skilaru1/ece3872swProj/HWProj/design.brd

## EAGLE design HWProj/design.brd (2020-04-04)

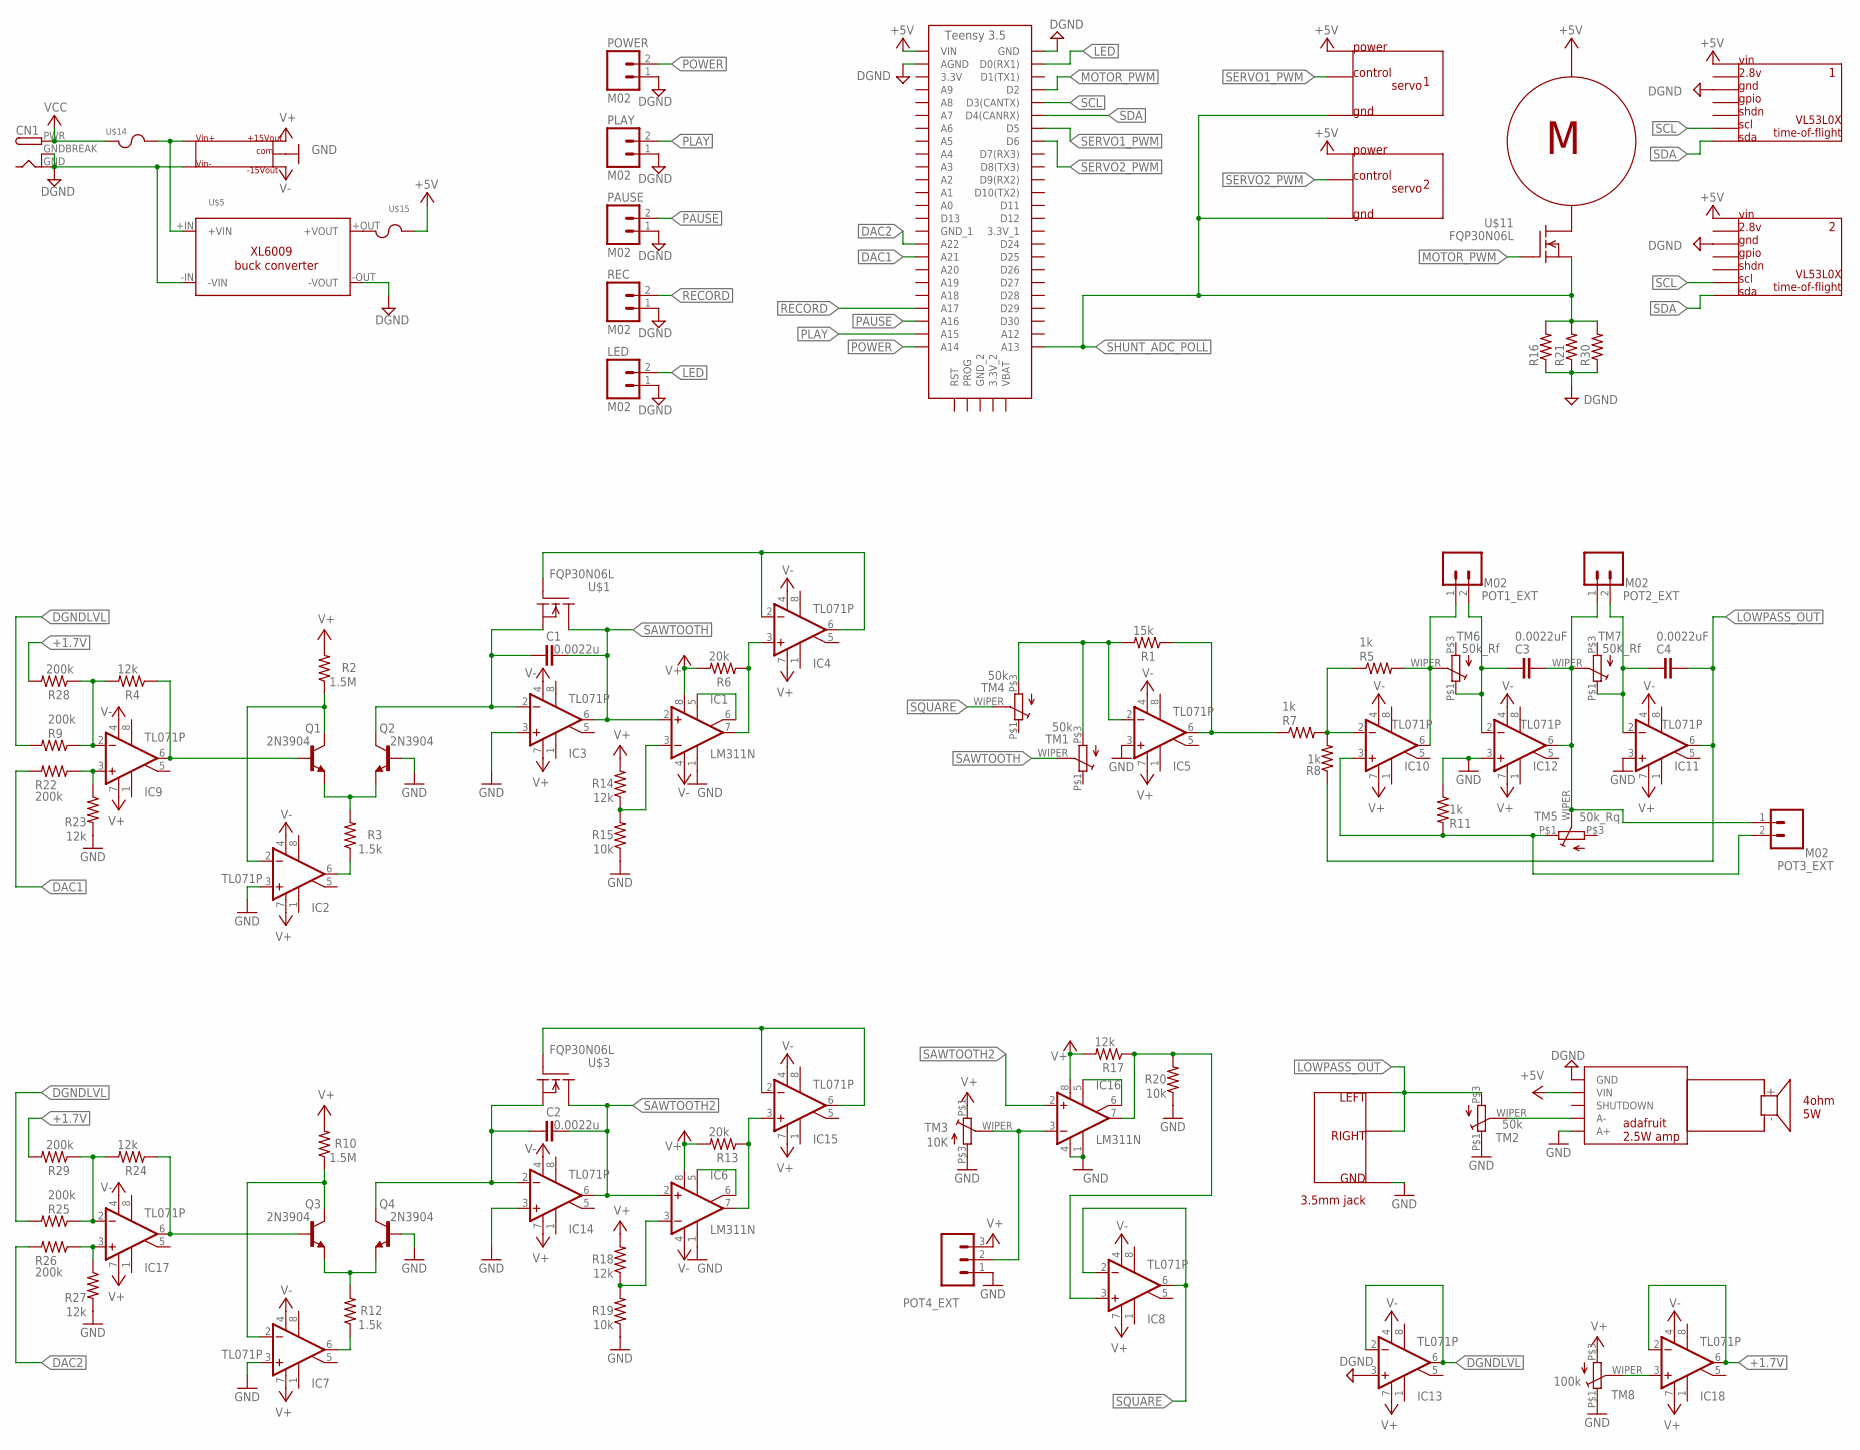
[picture p1: schematic design.sch]

Parts:
C1, C2: 0.0022u; CAP-PTH-5MM
C3, C4: 0.0022uF; CAP-PTH-5MM
CN1: DCBARRELPTH; DCJACK_2MM_PTH
IC1, IC6, IC16: LM311N; DIL08
IC2, IC3, IC4, IC5, IC7, IC8, IC9, IC10, IC11, IC12, IC13, IC14, IC15, IC17, IC18: TL071P; DIL08
LED: M02; 1X02
PAUSE: M02; 1X02
PLAY: M02; 1X02
POT1_EXT, POT2_EXT, POT3_EXT: M02; 1X02
POT4_EXT: M03; 1X03
POWER: M02; 1X02
Q1, Q2, Q3, Q4: 2N3904; TO92
R1: 15k; AXIAL-0.3
R2, R10: 1.5M; AXIAL-0.3
R3, R12: 1.5k; AXIAL-0.3
R4, R14, R17, R18, R23, R24, R27: 12k; AXIAL-0.3
R5, R7, R8, R11: 1k; AXIAL-0.3
R6, R13: 20k; AXIAL-0.3
R9, R22, R25, R26, R28, R29: 200k; AXIAL-0.3
R15, R19, R20: 10k; AXIAL-0.3
R16, R21, R30: RESISTORAXIAL-0.3; AXIAL-0.3
REC: M02; 1X02
TM1, TM2, TM4: 50k; 3386_TRI
TM3: 10K; 3386_TRI
TM5: 50k_Rq; 3386_TRI
TM6: 50k_Rf; 3386_TRI
TM7: 50K_Rf; 3386_TRI
TM8: 100k; 3386_TRI
U$1, U$3, U$11: FQP30N06L; TO-220
U$2: PAM8302A_ADAFRUIT
U$4: TEENSY_3.5_EXT
U$5: DC/DC-STEP-DOWN-XL6009; DC/DC-STEP-UP-XL6009
U$6: 3.5MM_AUDIO_JACK
U$7: +/-15V_BOOST_CONVERTER
U$8, U$9: SERVO_3PIN_HEADER
U$10: 3872_MOTOR
U$12, U$13: VL53L0X
U$14, U$15: FUSE_5X20MM; 0751.0110

Connections:
+1.7V: IC18.2 (-IN), IC18.6 (OUT), R28.P$2 (2), R29.P$2 (2)
+5V: U$2.VIN, U$4.VIN, U$8.POWER, U$9.POWER, U$10.+, U$12.VIN, U$13.VIN, U$15.R1 (2), U$15.R2 (2)
BANDPASS_OUT: C3.1, IC12.6 (OUT), POT2_EXT.1, POT3_EXT.1, TM5.WIPER (S), TM7.WIPER (S)
COMP_SQ_OUT: IC8.3 (+IN), IC16.7 (OUT), R17.P$1 (1), R20.P$2 (2)
DAC1: R22.P$2 (2), U$4.A21
DAC2: R26.P$2 (2), U$4.A22
DGND: CN1.GND, CN1.GNDBREAK, IC13.3 (+IN), LED.1, PAUSE.1, PLAY.1, POWER.1, R16.P$1 (1), R21.P$1 (1), R30.P$1 (1), REC.1, U$2.GND, U$4.AGND, U$4.GND, U$5.-IN (-VIN), U$5.-OUT (-VOUT), U$7.1, U$12.GND, U$13.GND
DGNDLVL: IC13.2 (-IN), IC13.6 (OUT), R9.P$2 (2), R25.P$2 (2)
GND: IC1.1 (GND), IC2.3 (+IN), IC3.3 (+IN), IC5.3 (+IN), IC6.1 (GND), IC7.3 (+IN), IC11.3 (+IN), IC12.3 (+IN), IC14.3 (+IN), IC16.1 (GND), IC16.4 (V-), POT4_EXT.1, Q2.2 (B), Q4.2 (B), R11.P$1 (1), R15.P$1 (1), R19.P$1 (1), R20.P$1 (1), R23.P$2 (2), R27.P$2 (2), TM2.P$1 (E), TM3.P$3 (A), TM8.P$1 (E), U$2.A+, U$6.GND, U$7.7
HIGHPASS_OUT: IC10.6 (OUT), POT1_EXT.1, R5.P$2 (2), TM6.WIPER (S)
INPUT2: IC5.6 (OUT), R1.P$1 (1), R7.P$1 (1)
LED: LED.2, U$4.D0(RX1)
LOWPASS_OUT: C4.1, IC11.6 (OUT), R8.P$1 (1), TM2.P$3 (A), U$6.L, U$6.R
MOTOR_PWM: U$4.D2, U$11.1 (G)
unnamed: TM2.WIPER (S), U$2.A-
unnamed: Q1.3 (E), Q2.3 (E), R3.P$2 (2)
unnamed: Q3.3 (E), Q4.3 (E), R12.P$2 (2)
unnamed: IC18.3 (+IN), TM8.WIPER (S)
unnamed: IC2.6 (OUT), R3.P$1 (1)
unnamed: IC1.7 (OUT), IC4.3 (+IN), R6.P$1 (1)
unnamed: C1.1, IC3.2 (-IN), Q2.1 (C), U$1.3 (S)
unnamed: IC6.7 (OUT), IC15.3 (+IN), R13.P$1 (1)
unnamed: IC1.5 (ON), IC1.6 (ON/STR)
unnamed: IC4.2 (-IN), IC4.6 (OUT), U$1.1 (G)
unnamed: IC17.3 (+IN), R26.P$1 (1), R27.P$1 (1)
unnamed: IC2.2 (-IN), Q1.1 (C), R2.P$1 (1)
unnamed: IC7.6 (OUT), R12.P$1 (1)
unnamed: C2.1, IC14.2 (-IN), Q4.1 (C), U$3.3 (S)
unnamed: IC6.5 (ON), IC6.6 (ON/STR)
unnamed: IC15.2 (-IN), IC15.6 (OUT), U$3.1 (G)
unnamed: IC16.5 (ON), IC16.6 (ON/STR)
unnamed: IC10.2 (-IN), R5.P$1 (1), R7.P$2 (2), R8.P$2 (2)
unnamed: IC17.6 (OUT), Q3.2 (B), R24.P$1 (1)
unnamed: C3.2, IC12.2 (-IN), POT1_EXT.2, TM6.P$1 (E)
unnamed: IC7.2 (-IN), Q3.1 (C), R10.P$1 (1)
unnamed: C4.2, IC11.2 (-IN), POT2_EXT.2, TM7.P$1 (E)
unnamed: IC6.3 (-IN), R18.P$1 (1), R19.P$2 (2)
unnamed: IC1.3 (-IN), R14.P$1 (1), R15.P$2 (2)
unnamed: IC10.3 (+IN), POT3_EXT.2, R11.P$2 (2), TM5.P$1 (E)
unnamed: IC16.3 (-IN), POT4_EXT.2, TM3.WIPER (S)
unnamed: IC17.2 (-IN), R24.P$2 (2), R25.P$1 (1), R29.P$1 (1)
unnamed: IC5.2 (-IN), R1.P$2 (2), TM1.P$3 (A), TM4.P$3 (A)
unnamed: U$5.+IN (+VIN), U$7.2, U$14.R1 (2), U$14.R2 (2)
unnamed: IC9.2 (-IN), R4.P$2 (2), R9.P$1 (1), R28.P$1 (1)
unnamed: IC9.3 (+IN), R22.P$1 (1), R23.P$1 (1)
unnamed: U$5.+OUT (+VOUT), U$15.L1 (1), U$15.L2 (1)
unnamed: U$10.-, U$11.2 (D)
PAUSE: PAUSE.2, U$4.A16
PLAY: PLAY.2, U$4.A15
POWER: POWER.2, U$4.A14
RECORD: REC.2, U$4.A17
SAWTOOTH: C1.2, IC1.2 (+IN), IC3.6 (OUT), TM1.WIPER (S), U$1.2 (D)
SAWTOOTH2: C2.2, IC6.2 (+IN), IC14.6 (OUT), IC16.2 (+IN), U$3.2 (D)
SCL: U$4.D3(CANTX), U$12.SCL, U$13.SCL
SDA: U$4.D4(CANRX), U$12.SDA, U$13.SDA
SERVO1_PWM: U$4.D5, U$8.CONTROL
SERVO2_PWM: U$4.D6, U$9.CONTROL
SHUNT_ADC_POLL: R16.P$2 (2), R21.P$2 (2), R30.P$2 (2), U$4.A13, U$8.GND, U$9.GND, U$11.3 (S)
SIGNAL1: IC9.6 (OUT), Q1.2 (B), R4.P$1 (1)
SQUARE: IC8.2 (-IN), IC8.6 (OUT), TM4.WIPER (S)
V+: IC1.8 (V+), IC2.7 (V+), IC3.7 (V+), IC4.7 (V+), IC5.7 (V+), IC6.8 (V+), IC7.7 (V+), IC8.7 (V+), IC9.7 (V+), IC10.7 (V+), IC11.7 (V+), IC12.7 (V+), IC13.7 (V+), IC14.7 (V+), IC15.7 (V+), IC16.8 (V+), IC17.7 (V+), IC18.7 (V+), POT4_EXT.3, R2.P$2 (2), R6.P$2 (2), R10.P$2 (2), R13.P$2 (2), R14.P$2 (2), R17.P$2 (2), R18.P$2 (2), TM3.P$1 (E), TM8.P$3 (A), U$7.6
V-: IC1.4 (V-), IC2.4 (V-), IC3.4 (V-), IC4.4 (V-), IC5.4 (V-), IC6.4 (V-), IC7.4 (V-), IC8.4 (V-), IC9.4 (V-), IC10.4 (V-), IC11.4 (V-), IC12.4 (V-), IC13.4 (V-), IC14.4 (V-), IC15.4 (V-), IC17.4 (V-), IC18.4 (V-), U$7.8
VCC: CN1.PWR, U$14.L1 (1), U$14.L2 (1)

Notes on the sheet:
4ohm 5W
3.5mm jack

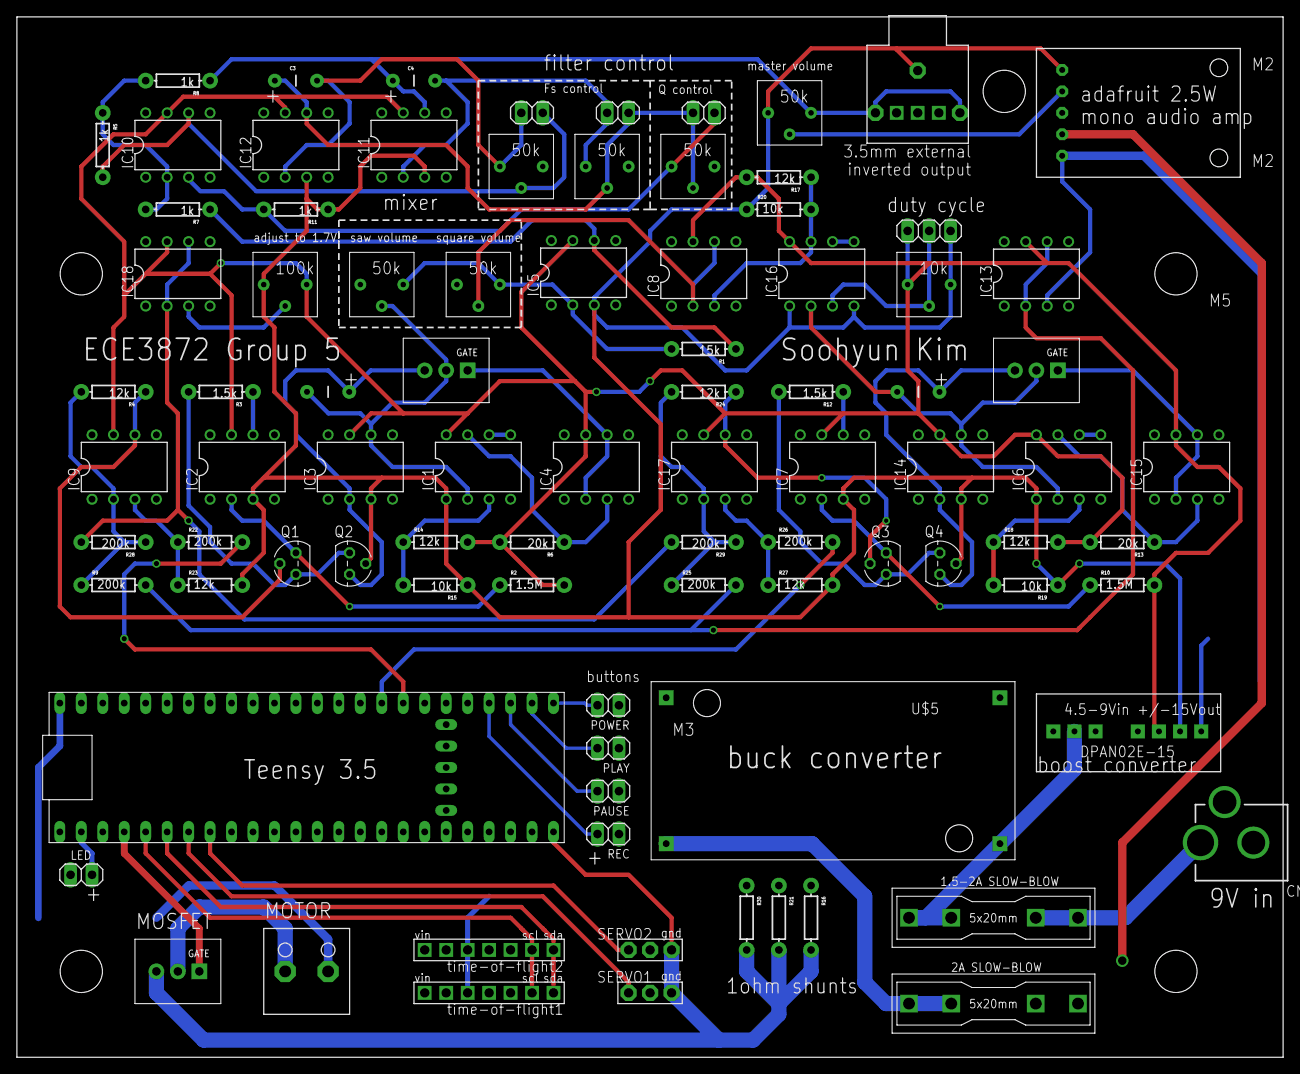
[picture p2: board design.brd from above]

Board: 2 copper layers, 149.8 x 123.1 mm, 89 parts (0 on the bottom side), 63 nets.
