skilaru1/ece3872swProj/(commit log)

2020-02-04 Left turn not working
    [SWProj.ino]
2020-02-05 fixed curr zero issue
    [SWProj.ino]
2020-02-25 added schematic
    [design.sch]
2020-02-26 1st order vcf and 2nd order manual filter added (unsimulated)
    [design.sch]
2020-02-27 tested two-pole filter circuit, determined r/c val
    [design.sch]
2020-02-27 removed extraneous components for analog--complete
    [design.sch]
2020-02-28 incorporated adafruit amp, minor revisions
    [design.sch]
2020-03-04 begin designing entire schematic, added power
    [design.sch]
2020-03-04 changed value of volume control pot at speaker stage to 50k
    [design.sch]
2020-03-04 corrected teensy vin
    [design.sch]
2020-03-06 added teensy 3.5 DAC test code
2020-03-07 completed initial design for testing, revisions
    [design.sch]
2020-03-09 added 3.5mm jack
    [design.sch]
2020-03-09 fixed ground ref for amp, replaced boost converter
    [design.sch]
2020-03-10 added board rev0
    [design.brd, design.sch]
2020-03-10 revised board rev0.2
    [design.brd]
2020-03-11 added motor, sensors, and servos--board rev1
    [design.brd, design.sch]
2020-03-11 silkscreen cleanup, tested square generation
    [design.brd, design.sch]
2020-03-12 added fuses, shunt system, finalized board rev1.1
    [design.brd, design.sch]
2020-03-12 revised teensy test code to light LED
2020-04-02 Added code for button and servo functions
2020-04-03 attempted integration of buttons and servos
    [design.brd, design.sch]
2020-04-03 minor commit; added silkscreen text
    [design.brd]
2020-04-04 post-prototype evaluation revisions
    [design.brd, design.sch]
2020-04-06 added DC Motor functionality
2020-04-10 Left ToF and Overcurrent Added
    Need to work with Soohyun on the overcurrent, right now I'm reading an analog voltage from A12 assuming we'd put a resistor on the other side of the pin. Outside of that, all of the ToF I2C code works with the rest of our code. Implementing a second ToF sensor would be easy as well and I can add that blank code if we'd like.
2020-04-10 Fixed the analogRead pin
    [buttons_and_servo.ino]
